JorisTDP/Camera/UI.jpg

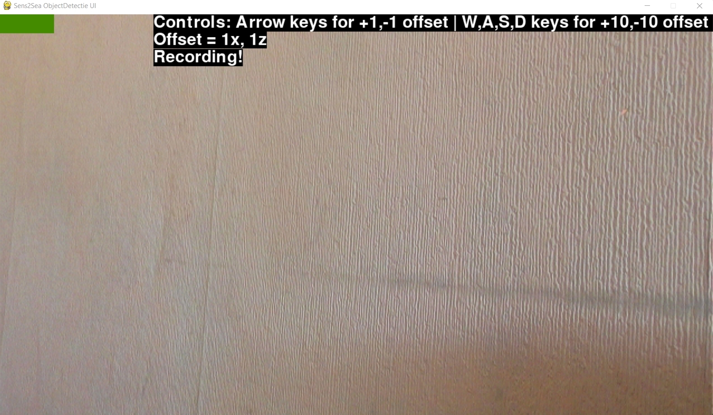
UI.jpg
