JorisTDP/Camera/Sockets/demo.jpg

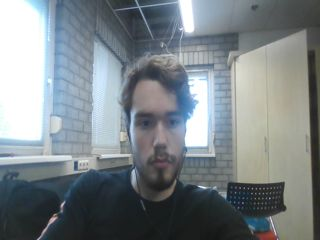
Sockets/demo.jpg
