JorisTDP/Camera/OLD-Documentation/opleversetHJ/opleverset/50p_presentatie.pdf

# 50% presentatie

## Henkjan

woensdag 20 april 2022

2

# Impressie van stage

- Geheel anders dan vorige stage
- – dichtbij
- – informele sfeer
- – goed contact met collega’s
- – betere opdracht
- – betere begeleiding

woensdag 20 april 2022

3

# Voortgang

- Verder werken aan stabiliseringsplatform
- Opnieuw bouwen
- Testen op schip

woensdag 20 april 2022

4

# Vanaf nu

- Platform én tracking in één systeem
- Twee sensoren
- Gyroscoop
- Realiseren

woensdag 20 april 2022

5

“
”

# Vragen
