JorisTDP/Camera/(list of files, cad)

Other CAD files:
cableholder.blend
