JorisTDP/Camera/OLD-Documentation/opleversetHJ/opleverset/95p_presentatie.pdf

## 95% presentatie

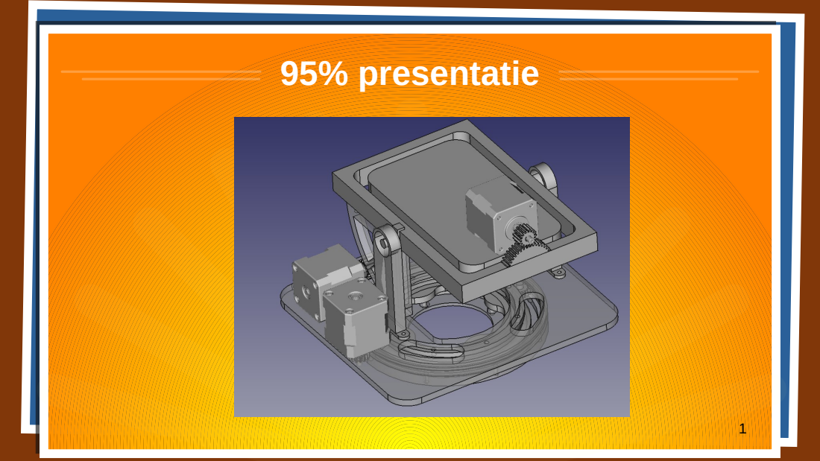
[picture p13: page 1]

## Opdracht

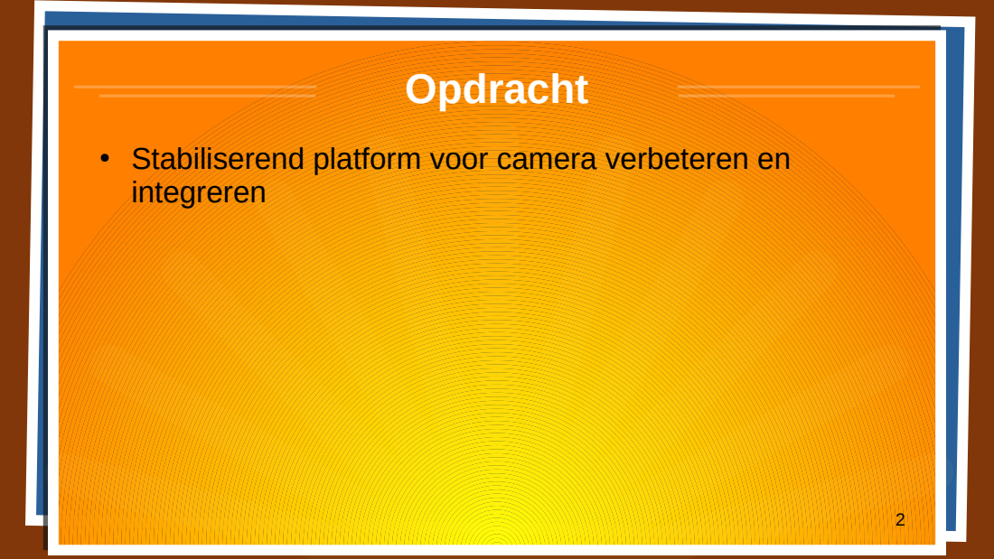
[picture p14: page 2]

● Stabiliserend platform voor camera verbeteren en
integreren

## Waarmee begon ik?

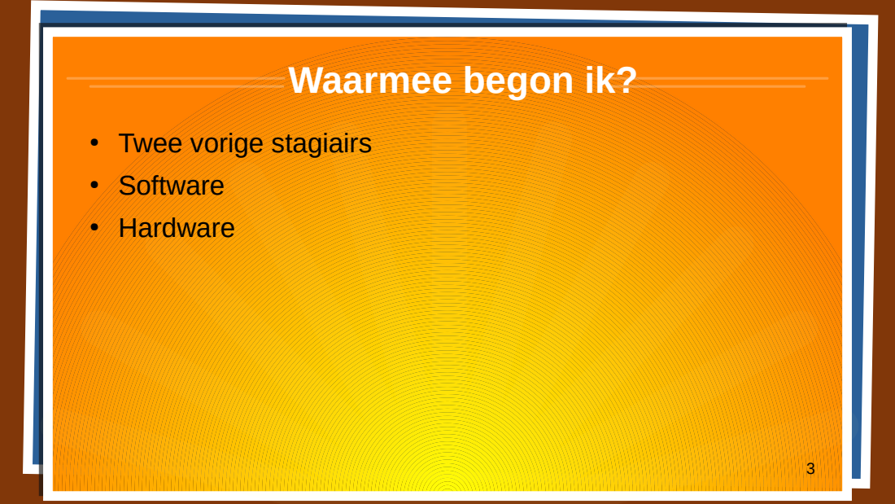
[picture p15: page 3]
● Software; ● Hardware

● Twee vorige stagiairs

## Voortgang

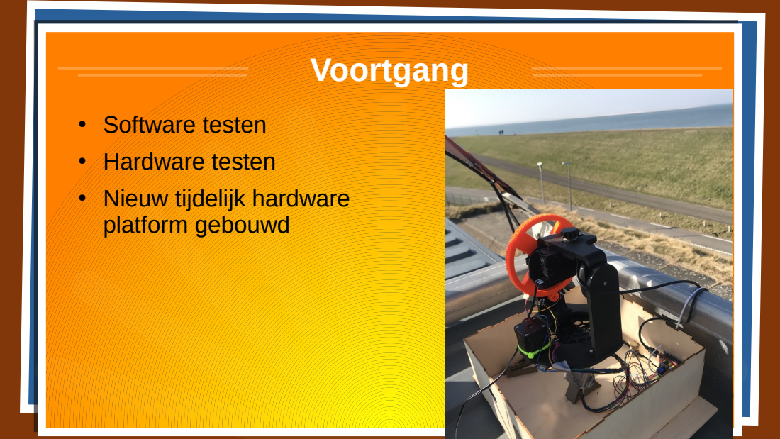
[picture p16: page 4]
● Software testen; ● Hardware testen

● Nieuw tijdelijk hardware
platform gebouwd

## Voortgang

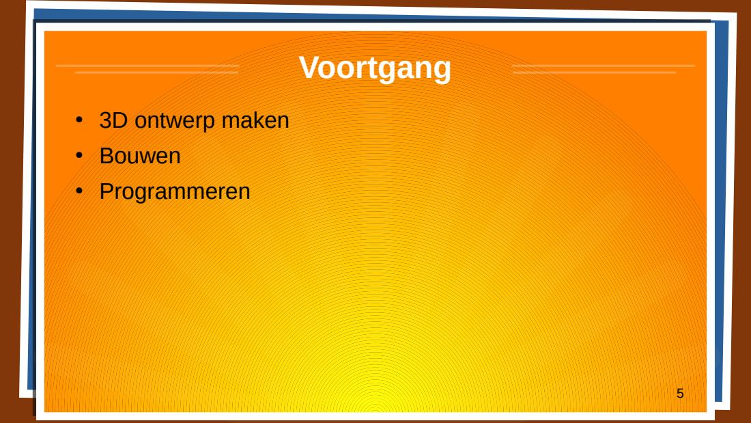
[picture p17: page 5]
● 3D ontwerp maken; ● Bouwen; ● Programmeren

## Voortgang

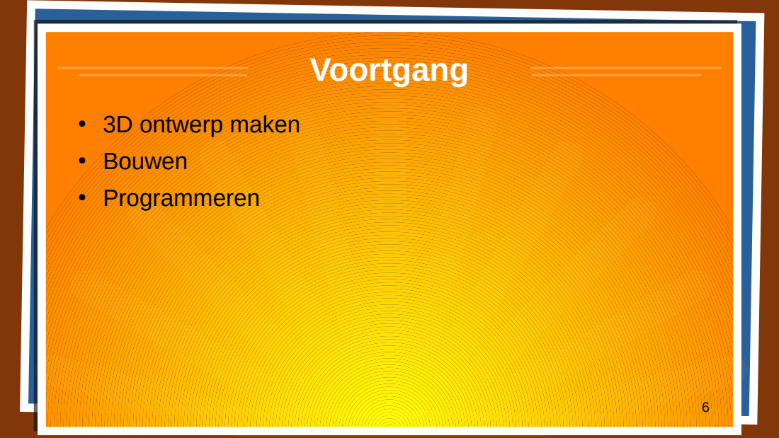
[picture p18: page 6]
● 3D ontwerp maken; ● Bouwen; ● Programmeren

## Komende week

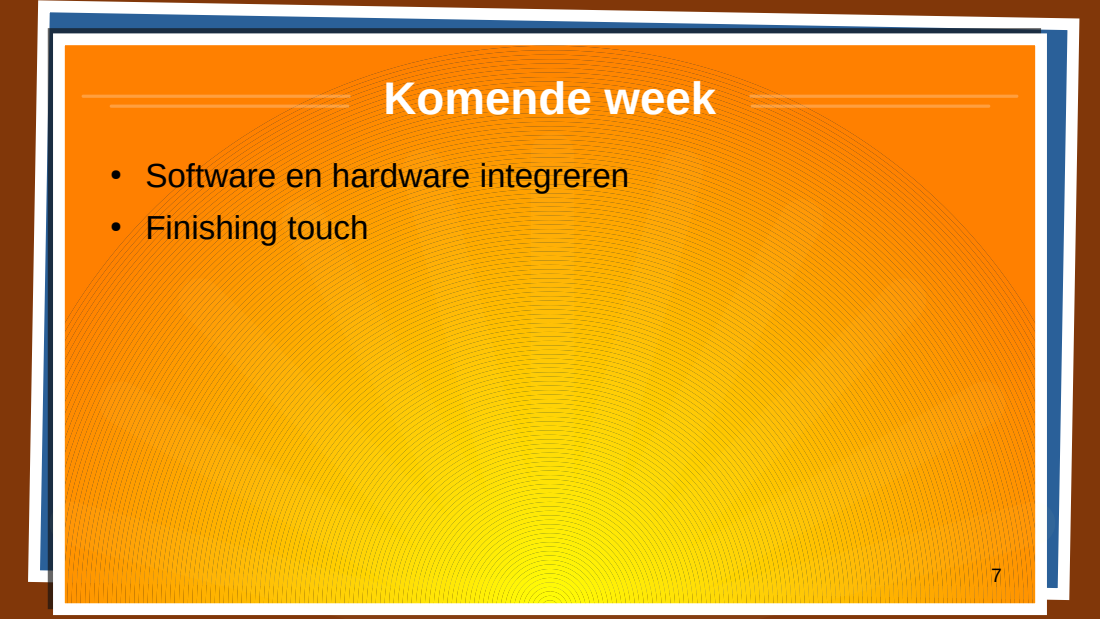
[picture p19: page 7]
● Finishing touch

● Software en hardware integreren

## Vragen?

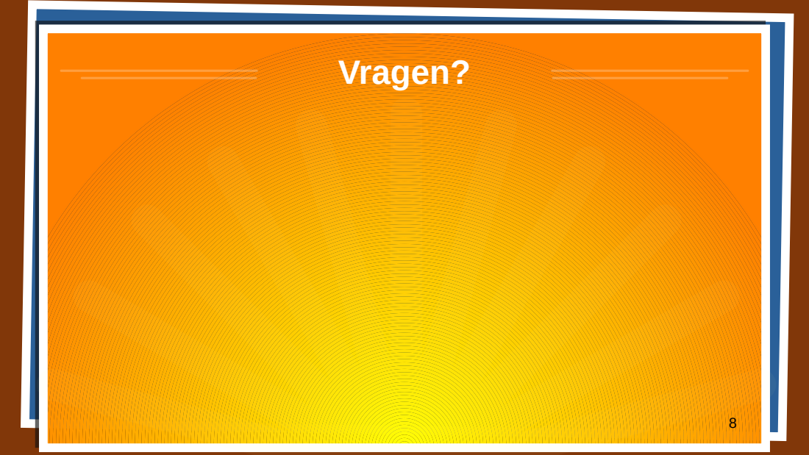
[picture p20: page 8]
