JorisTDP/Camera/Sockets/camera.py

#!python3.9
import cv2
import pygame
import numpy as np
import time
import socket
import datetime
import os
from input import Communication


import sys

from pygame.locals import *

CAMERA_IP = "127.0.0.1"
CAMERA_PORT = 8002

class UserInterface():
    def __init__(self, width: int, height: int):
        self.width = width
        self.height = height
        self.offsetx = 1
        self.offsetz = 1

        self.clock = pygame.time.Clock()
        self.communication = Communication(CAMERA_IP, CAMERA_PORT)

        # Start pygame and create a screen
        pygame.init()
        pygame.display.set_caption("Sens2Sea ObjectDetectie UI")
        self.screen = pygame.display.set_mode([self.width, self.height])

        self.cap = cv2.VideoCapture(0, cv2.CAP_DSHOW)
        self.cap.set(cv2.CAP_PROP_FPS, 60)

        self.frame_width = self.width #int(self.cap.get(3))
        self.frame_height = self.height #int(self.cap.get(4))

        current_time = datetime.datetime.now()

        os.system('cd Recordings')
        os.system('mkdir ' + str(current_time.month) + '-' + str(current_time.day) )

        self.size = (self.frame_width, self.frame_height)

        #filepath = 'C:/Users/joris/Desktop/Stage/Camera/' + str(current_time.month) + '-' + str(current_time.day) + '/out.avi'
        self.counter = 0

        #set the output files for a session in an array. 
        self.result = [cv2.VideoWriter('output1.avi',cv2.VideoWriter_fourcc(*'MJPG'),30, self.size), cv2.VideoWriter('output2.avi',cv2.VideoWriter_fourcc(*'MJPG'),30, self.size), cv2.VideoWriter('output3.avi',cv2.VideoWriter_fourcc(*'MJPG'),30, self.size), cv2.VideoWriter('output4.avi',cv2.VideoWriter_fourcc(*'MJPG'),30, self.size),cv2.VideoWriter('output5.avi',cv2.VideoWriter_fourcc(*'MJPG'),30, self.size)]

        self.input_rect = pygame.Rect(0, 0, 440, 34)

        self.base_font = pygame.font.Font(None, 32)
        self.user_text = ''
  
        self.color_active = pygame.Color('lightskyblue3')

        self.color_passive = pygame.Color('chartreuse4')
        self.color = self.color_passive

        self.active = False # check if button prompt is active
        self.executed = False # used to run code only once
        self.recording = True 
        self.running = 1

    def update_screen(self, frame):
            # reset screen
            self.screen.fill([0, 0, 0])

            #self.filename = 'output' + str(self.counter) + '.avi'
            #self.result = cv2.VideoWriter(self.filename,cv2.VideoWriter_fourcc(*'MJPG'),30, self.size)

            if(type(frame) != type(None)): 
                temp_frame = cv2.resize(frame, (1280, 720), interpolation=cv2.INTER_AREA) # setup the frame for record mode
                frame = temp_frame

                temp_frame = cv2.cvtColor(frame, cv2.COLOR_BGR2RGB)  #setup frame for display in the user interface
                temp_frame = np.rot90(temp_frame)
                temp_frame = cv2.flip(temp_frame, 0)
                temp_frame = cv2.resize(temp_frame, (720, 1280), interpolation=cv2.INTER_AREA) # rotate, flip and resize the frame of the camera
                temp_frame = pygame.surfarray.make_surface(temp_frame) # create a surface from the camera frame

                self.screen.blit(temp_frame, (0,0)) # display the camera frame in user interface

            font = pygame.font.Font('freesansbold.ttf', 30)

            width = self.width
            height = self.height

            # Display available controls
            txt = "Controls: Arrow keys for +1,-1 offset | W,A,S,D keys for +10,-10 offset "
            text = font.render(txt, True, (255,255,255), (0,0,0))
            self.screen.blit(text, (width - font.size(txt)[0],0))

            #Display current offset
            offs = "Offset = " + str(self.offsetx) + "x, " + str(self.offsetz) + "z"
            offset_text = font.render(offs, True, (255,255,255), (0,0,0))
            self.screen.blit(offset_text, (width - font.size(txt)[0],31))

            if self.recording == False:
                if self.executed == False:
                    self.result[self.counter].release()
                    self.counter+= 1
                    #self.result = cv2.VideoWriter('out1.avi',cv2.VideoWriter_fourcc(*'MJPG'),30, self.size)
                    self.executed = True
                rec = "Not Recording."
            else:
                rec = "Recording!"
                self.result[self.counter].write(frame)
                self.executed = False
                
            rec_text = font.render(rec, True, (255,255,255), (0,0,0))
            self.screen.blit(rec_text, (width - font.size(txt)[0],62))

            pygame.display.update()
            
            return pygame.event.get()

    def handle_user_event(event, self): # handle user events, key presses and such
        if event.type == pygame.QUIT:
            del ui
        elif event.type == pygame.MOUSEBUTTONDOWN:
            if self.input_rect.collidepoint(event.pos):
                self.active = True
            else:
                self.active = False

        elif event.type == KEYDOWN:

            if self.active == True:
                if event.key == pygame.K_BACKSPACE:
                    self.user_text = self.user_text[:-1]
                elif event.key == pygame.K_RETURN:
                    self.communication.send_input(self.user_text)
                    self.user_text = ''
                else: 
                    self.user_text += event.unicode    
            else:
                if event.key == K_UP:
                    self.offsetz -= 1
                if event.key == K_DOWN:
                    self.offsetz += 1
                if event.key == K_LEFT:
                    self.offsetx += 1
                if event.key == K_RIGHT:
                    self.offsetx -= 1
                if event.key == K_w:
                    self.offsetz -= 10
                if event.key == K_s:
                    self.offsetz += 10
                if event.key == K_a:
                    self.offsetx += 10
                if event.key == K_d:
                    self.offsetx -= 10
                if event.key == K_r:
                    if self.recording == False:
                        self.recording = True
                    else:
                        self.recording = False

            self.communication.send_offset(self.offsetx, self.offsetz) #send offset to socket client
    
    def input(self): # draws input_rect
        pygame.draw.rect(self.screen, self.color, self.input_rect)
        text_surface = self.base_font.render(self.user_text, True, (255, 255, 255))
        self.screen.blit(text_surface, (self.input_rect.x+5, self.input_rect.y+5))
        self.input_rect.w = max(100, text_surface.get_width()+10)
        pygame.display.flip()
        self.clock.tick(60)

    def main_loop(self): 
        while True: # self.running:
            success, frame = self.cap.read()
            if not success:
                break   
            if self.active: # if input box is clicked set the color to active
                self.color = self.color_active
            else: # else color is passive
                self.color = self.color_passive

            UserInterface.input(self)
            pygame_events = UserInterface.update_screen(self, frame)

            for event in pygame_events:
                UserInterface.handle_user_event(event, self)


class UIShutdown(Exception):
    def __init__(self):
        super().__init__("The UI will to be shut down according to user input!")

ui = UserInterface(1280, 720)
ui.main_loop()
