JorisTDP/Camera/(commit log)

2022-09-05 Sockets uitgewerkt
    werkt nog niet met arduino helaas
2022-09-08 Camera working
2022-09-13 worked on sockets
2022-09-19 simpele wiskunde fix voor yaw
    [mpu6050_to_cnc_shield.ino, radar_simulation.py, socket_client.py]
2022-09-22 Yaw + Pitch werken
2022-09-27 yaw werkt met mini afwijking
    [cableholder.blend, multiplier.xlsx]
2022-10-06 werkend prototype
    [multiplier.xlsx]
2022-10-24 Sockets bijna werkend
2022-12-02 record mode added (not working yet)
    [camera.py]
2023-01-26 Code review feedback added
    [multiplier.xlsx]
